ZackHirshhorn/Nested-Motor-Experiment/analysis/example/carrier_selection.md

# Carrier selection

Carrier at 3 V, inner at 3 V, cradle parasitic torque 0.8 mN·m.

| Carrier | Inner | carrier stall / τ_par | cradle rpm | ω_out free (rpm) | ideal sum of free speeds (rpm) | combined stall torque (mN·m) | verdict |
|---|---|---|---|---|---|---|---|
| A | B | 6.7 | 7467 | 17495 | 18798 | 3.82 | OK |
| B | A | 4.2 | 7668 | 16438 | 18798 | 3.59 | OK |

**Recommended carrier: motor A.**

Predicted role-swap effect on free-running ω_out: 1057 rpm (A as carrier is faster). Under output load both motors carry the same torque, so this difference stays constant along the combined torque-speed line.
