ZackHirshhorn/Nested-Motor-Experiment/analysis/example/motor_summary.md

# Phase 1 — motor characterization

Values at each motor's highest no-load test voltage. *Apparent kV* is the plan's definition (free rpm / V, includes friction and IR drop); *back-EMF kV* is 1/kE, the true motor constant. kT is fitted independently from the rope-brake points: it should match kE (same number in SI) if the data are self-consistent.

| Motor | V test | free rpm | apparent kV (rpm/V) | back-EMF kV (rpm/V) | kE = kT (mN·m/A) | kT from brake (mN·m/A) | R (Ω) | I0 @ free (A) | I stall (A) | τ stall (mN·m) | brake fit RMS (rpm) | J spin-up (g·cm²) | τ stall spin-up (mN·m) |
|---|---|---|---|---|---|---|---|---|---|---|---|---|---|
| A | 4.50 | 13346 | 2966 | 3185 | 2.998 | 2.934 | 1.600 | 0.194 | 2.81 | 8.19 | 141 | 4.91 | 5.47 |
| B | 4.50 | 15275 | 3394 | 3674 | 2.599 | 2.598 | 2.192 | 0.156 | 2.05 | 5.18 | 223 | 4.71 | 3.44 |
