ZackHirshhorn/Nested-Motor-Experiment/analysis/example/plots/carrier_selection.png

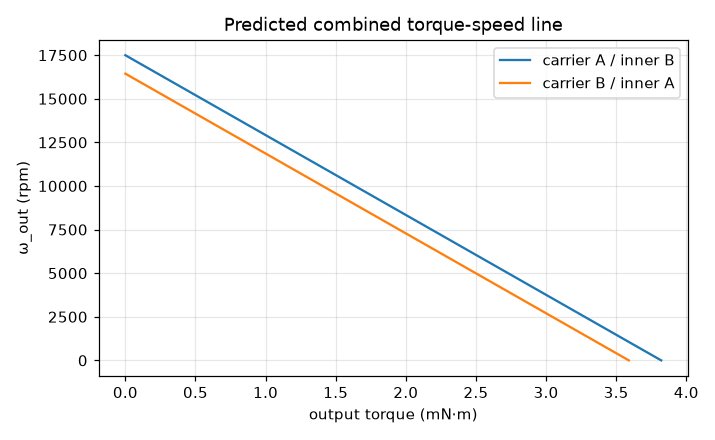
analysis/example/plots/carrier_selection.png
