ZackHirshhorn/Nested-Motor-Experiment/analysis/example/plots/torque_speed_A.png

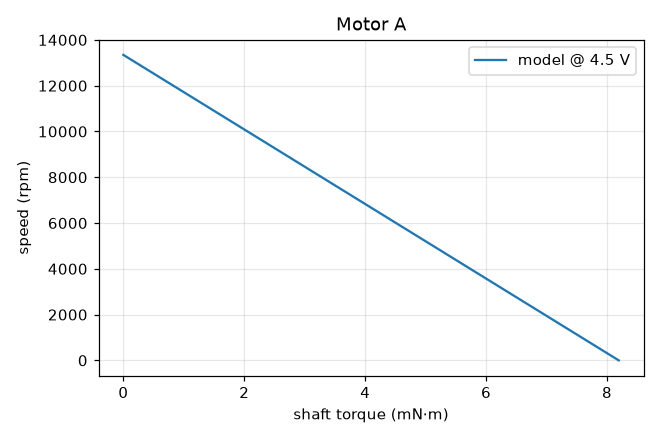
analysis/example/plots/torque_speed_A.png
