ZackHirshhorn/Nested-Motor-Experiment/analysis/example/plots/torque_speed_B.png

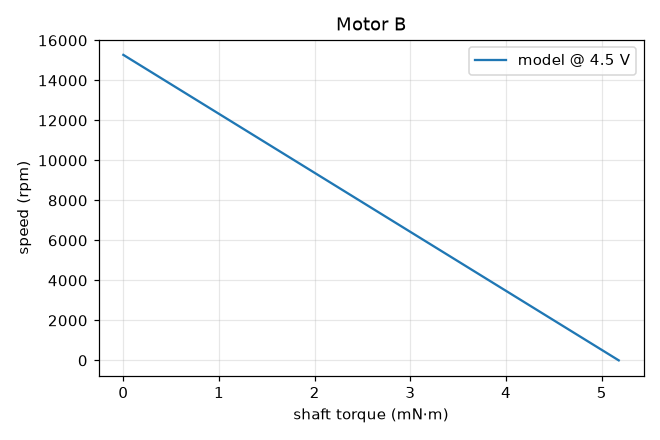
analysis/example/plots/torque_speed_B.png
