ZackHirshhorn/Nested-Motor-Experiment/docs/BOM.md

# Bill of Materials

_Generated by `python cad/rig.py` from the parametric model. Do not edit by hand; change cad/parameters.py or data/motor_dims.csv and re-run._

## Purchased parts

| Item | Qty | Spec / notes |
| --- | --- | --- |
| Brushed PM DC motor A | 1 | Exact model recorded in data/motor_dims.csv; characterized in Phase 1 |
| Brushed PM DC motor B | 1 | Same |
| Ball bearing 6801ZZ | 1 | 12x21x5 mm, metal shields (ZZ), NOT rubber-sealed 2RS (seal drag) |
| Ball bearing 6805ZZ | 1 | 25x37x7 mm, metal shields (ZZ), NOT rubber-sealed 2RS (seal drag) |
| Through-bore slip ring | 1 | >= 2 circuits, bore 12.7 mm, OD <= 40.0 mm, length <= 25.0 mm. **Choose the lowest rotating-torque spec you can find**: it must be well under the carrier's stall torque |
| Slotted opto-interrupter module (LM393 type) | 3 | 5 mm slot; 2 on the rig + 1 for the Phase 1 dynamometer |
| Arduino Uno / Nano (5 V) | 1 | Runs firmware/tachometer; timestamps pulses on D2 and D3 |
| Bench power supply, current-limited | 2 | One per motor, independently adjustable; current readout used as data |
| Multimeter | 1 | 4-wire resistance not needed; used for locked-rotor V/I and supply cross-checks |
| Digital force gauge (0-5 N, 0.01 N) + hanging masses (10-200 g) | 1 set | Rope-brake dynamometer |
| Braided cord, ~0.5 mm (fishing line / kevlar thread) | 1 m | Rope brake |
| Steel fender washer (e.g. M8 x 24 mm) | 1 | Known-inertia flywheel for the spin-up test; weigh it |
| Calipers | 1 | Motor dimensions and fit-coupon checks |
| Drill bit = motor shaft diameter (e.g. 2.0 mm) | 1 | Ream every printed shaft bore to size |
| Thin silicone hook-up wire (28-30 AWG) | 1 m | Inner motor leads through the rear cap to the slip ring |
| M3 x 10 screw + nut | 1 | Anti-rotation pin on the slip-ring stator (rides in the stop's window) |
| Clear polycarbonate sheet or printed guard | 1 | Shield around the spinning cradle (see Safety) |
| CA glue | - | Optional: lock press-fit discs on shafts |
| M3 heat-set insert | 25 | |
| M3 x 10 SHCS (base plate, from below) | 14 | |
| M3 x 12 SHCS (carrier mount cap) | 4 | |
| M3 x 16 SHCS (pedestal caps) | 2 | |
| M3 x 25 SHCS (pedestal caps) | 2 | |
| M3 x 6 set screw + M3 square nut (coupler hub) | 1 | |
| M3 x 8 SHCS (rear cap to cradle) | 3 | |

## 3D-printed parts

STLs are print-oriented in `cad/exports/carrier_<X>/`. Print `fit_coupon.stl` first and tune the fits in cad/parameters.py before printing the rest.

| Part | Qty | Material / notes |
| --- | --- | --- |
| base_plate.stl | 1 | PETG |
| carrier_mount_cap_A.stl | 1 | PETG |
| carrier_mount_cap_B.stl | 1 | PETG |
| carrier_mount_lower_A.stl | 1 | PETG |
| carrier_mount_lower_B.stl | 1 | PETG |
| coupler_hub.stl | 1 | PETG |
| cradle_body_A.stl | 1 | PETG, 100% infill (balance) |
| cradle_body_B.stl | 1 | PETG, 100% infill (balance) |
| dyno_drum_A.stl | 1 | PETG, supports under disc |
| dyno_drum_B.stl | 1 | PETG, supports under disc |
| encoder_disc_A.stl | 1 | PLA or PETG |
| encoder_disc_B.stl | 1 | PLA or PETG |
| oldham_disc.stl | 1 | PETG, supports under web |
| pedestal_front_cap.stl | 1 | PETG |
| pedestal_front_lower.stl | 1 | PETG |
| pedestal_rear_cap.stl | 1 | PETG |
| pedestal_rear_lower.stl | 1 | PETG |
| rear_cap_A.stl | 1 | PETG, 100% infill (balance) |
| rear_cap_B.stl | 1 | PETG, 100% infill (balance) |
| sensor_bracket.stl | 3 | PLA or PETG |
| slip_ring_stop.stl | 1 | PLA or PETG |
