ZackHirshhorn/Nested-Motor-Experiment/cad/exports/carrier_A/assembly_phase3_loaded.step

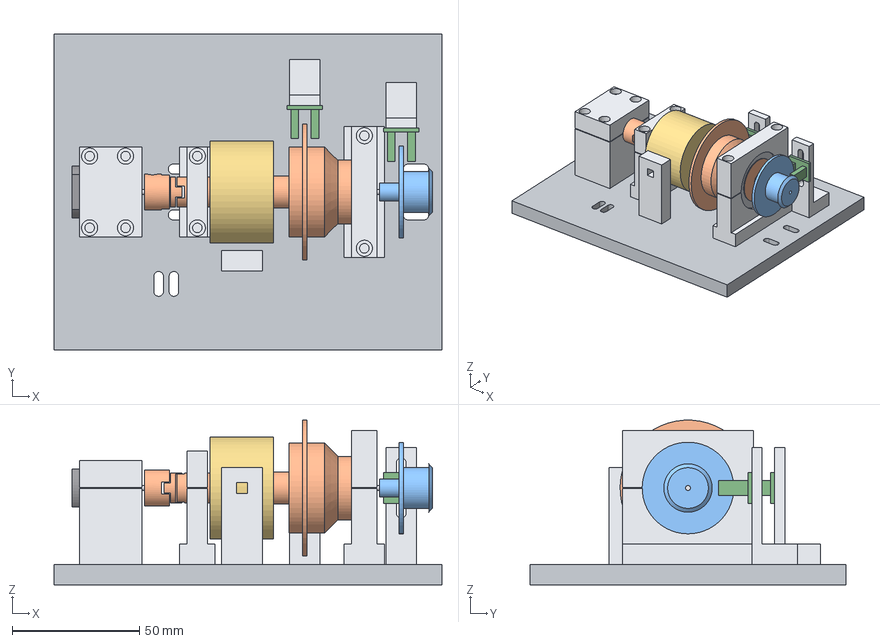
[picture p5: CAD file, 2026-10-30]
cad/exports/carrier_A/assembly_phase3_loaded.step
152.4 x 124.0 x 64.6 mm
base_plate
carrier_mount_lower
carrier_mount_cap
motor_carrier_can
motor_carrier_shaft
pedestal_front_lower
pedestal_front_cap
pedestal_rear_lower
pedestal_rear_cap
cradle_body
rear_cap
oldham_disc
coupler_hub
motor_inner_can
motor_inner_shaft
slip_ring_stop
slip_ring
bearing_front
bearing_rear
sensor_bracket
sensor_cradle
sensor_bracket_output
sensor_output
dyno_drum_inner
