ZackHirshhorn/Nested-Motor-Experiment/cad/exports/carrier_B/assembly_phase1.step

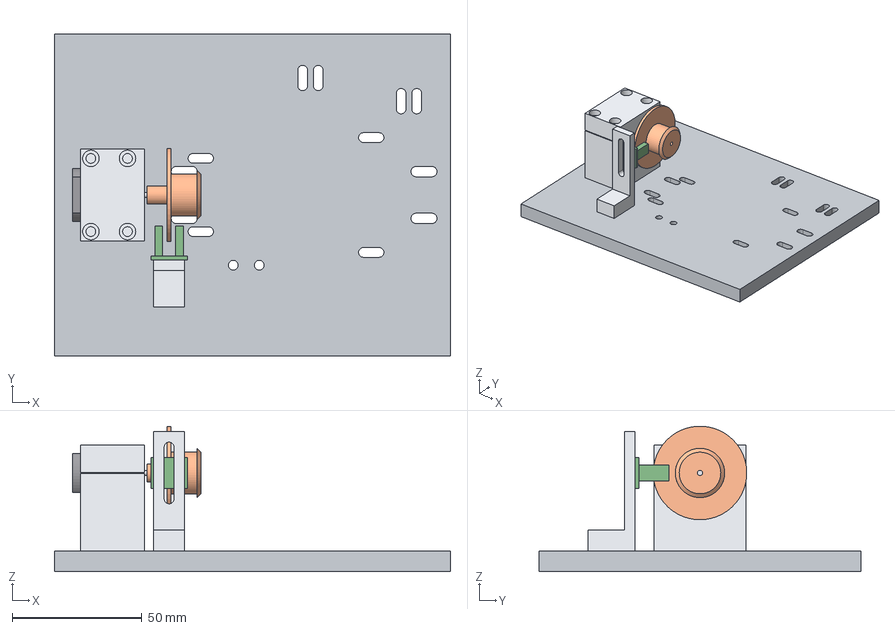
[picture p6: CAD file, 2026-10-30]
cad/exports/carrier_B/assembly_phase1.step
152.4 x 124.0 x 56.0 mm
base_plate
carrier_mount_lower
carrier_mount_cap
motor_carrier_can
motor_carrier_shaft
dyno_drum_carrier
sensor_bracket_p1
sensor_p1
