ZackHirshhorn/Nested-Motor-Experiment/cad/exports/carrier_A/encoder_disc_B.stl

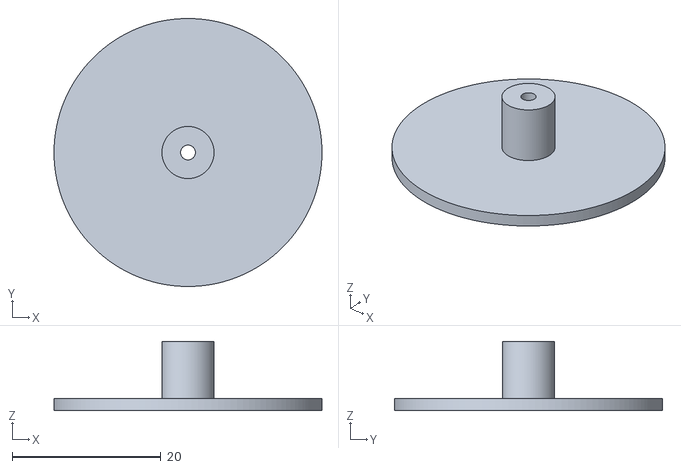
[picture p7: CAD file, 2026-10-30]
cad/exports/carrier_A/encoder_disc_B.stl
36.0 x 36.0 x 9.30
