ZackHirshhorn/Nested-Motor-Experiment/cad/exports/carrier_B/pedestal_rear_lower.stl

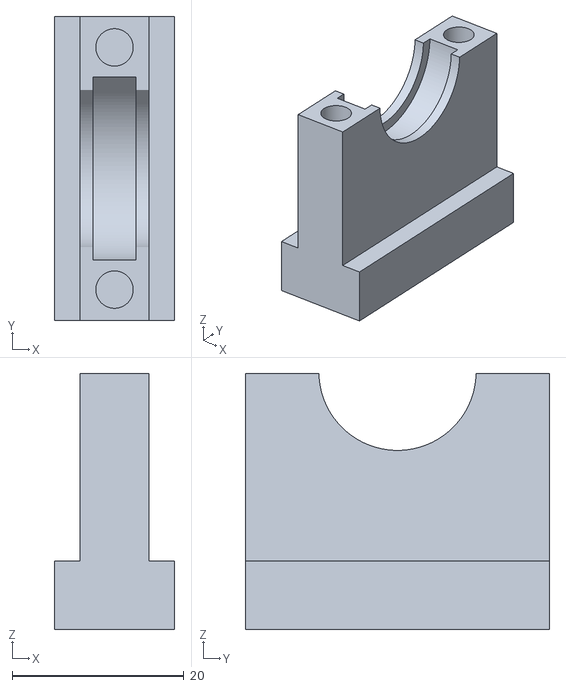
[picture p8: CAD file, 2026-10-30]
cad/exports/carrier_B/pedestal_rear_lower.stl
14.0 x 35.4 x 29.8
