ZackHirshhorn/Nested-Motor-Experiment/cad/exports/carrier_A/sensor_bracket.stl

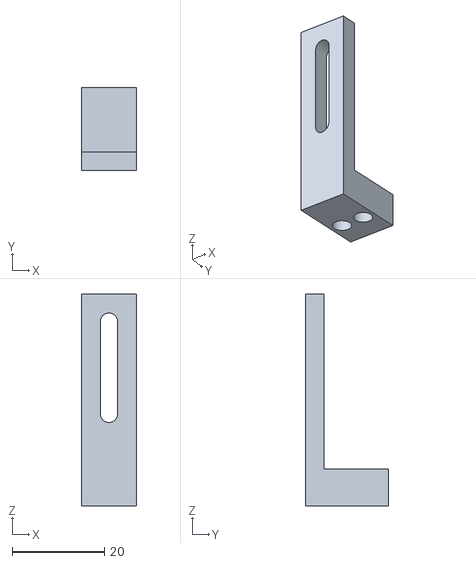
[picture p9: CAD file, 2026-10-30]
cad/exports/carrier_A/sensor_bracket.stl
12.0 x 18.0 x 46.0
