ZackHirshhorn/Nested-Motor-Experiment/cad/exports/carrier_B/pedestal_rear_cap.stl

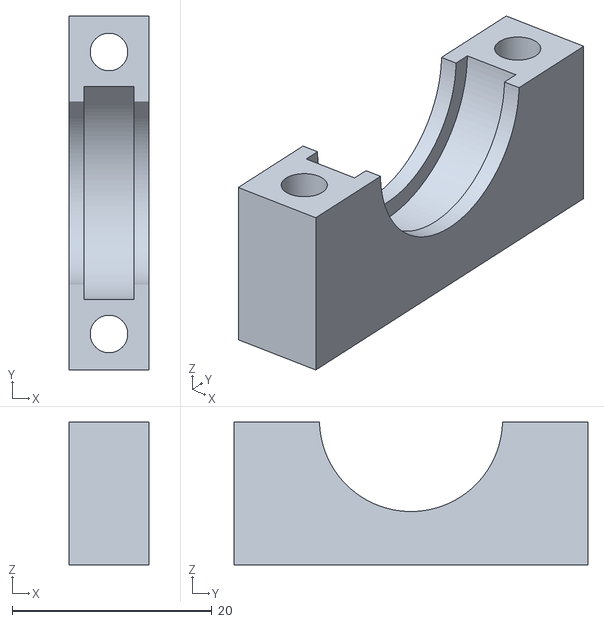
[picture p10: CAD file, 2026-10-30]
cad/exports/carrier_B/pedestal_rear_cap.stl
8.00 x 35.4 x 14.3
