ZackHirshhorn/Nested-Motor-Experiment/cad/exports/carrier_A/slip_ring_stop.stl

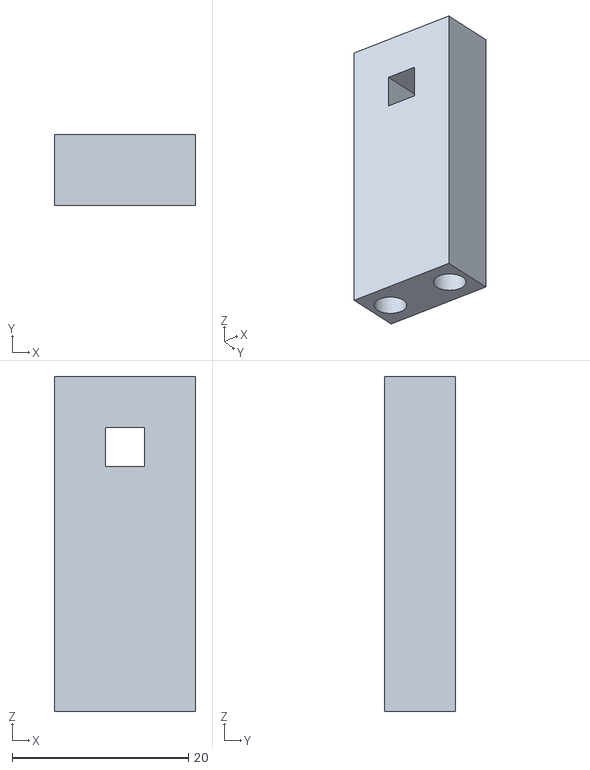
[picture p11: CAD file, 2026-10-30]
cad/exports/carrier_A/slip_ring_stop.stl
16.0 x 8.00 x 38.0
