ZackHirshhorn/Nested-Motor-Experiment/cad/exports/carrier_B/fit_coupon.stl

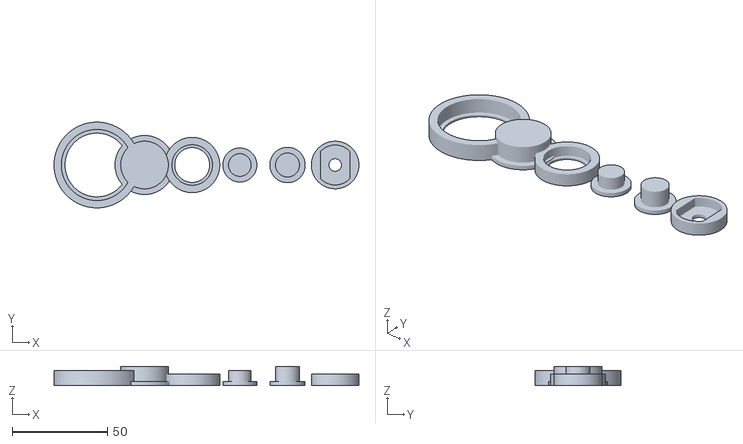
[picture p12: CAD file, 2026-10-30]
cad/exports/carrier_B/fit_coupon.stl
160.0 x 45.0 x 10.0
