ZackHirshhorn/Nested-Motor-Experiment/cad/exports/carrier_A/carrier_mount_lower_A.stl

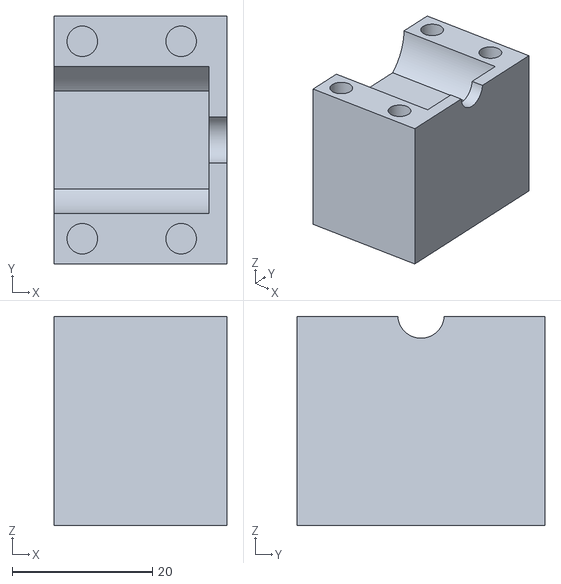
[picture p13: CAD file, 2026-10-30]
cad/exports/carrier_A/carrier_mount_lower_A.stl
24.6 x 35.3 x 29.8
