ZackHirshhorn/Nested-Motor-Experiment/cad/exports/carrier_B/carrier_mount_cap_B.stl

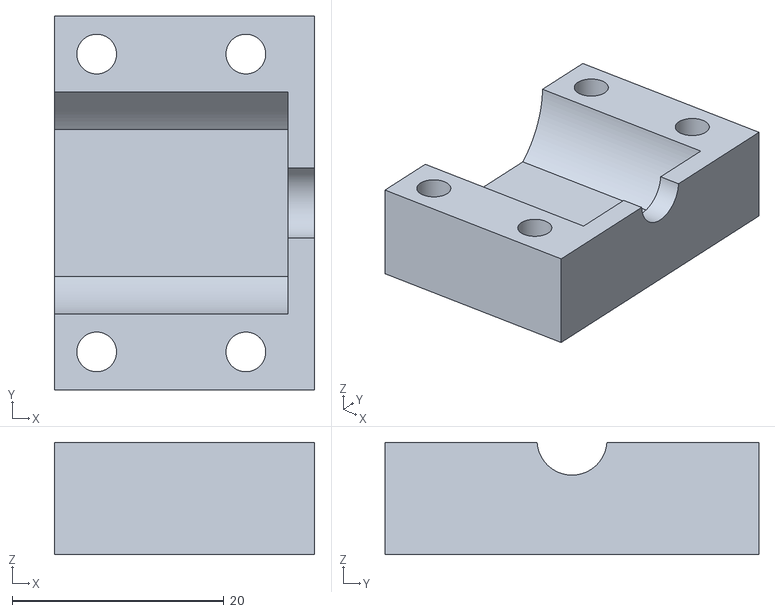
[picture p14: CAD file, 2026-10-30]
cad/exports/carrier_B/carrier_mount_cap_B.stl
24.6 x 35.3 x 10.6
