ZackHirshhorn/Nested-Motor-Experiment/cad/exports/carrier_B/dyno_drum_A.stl

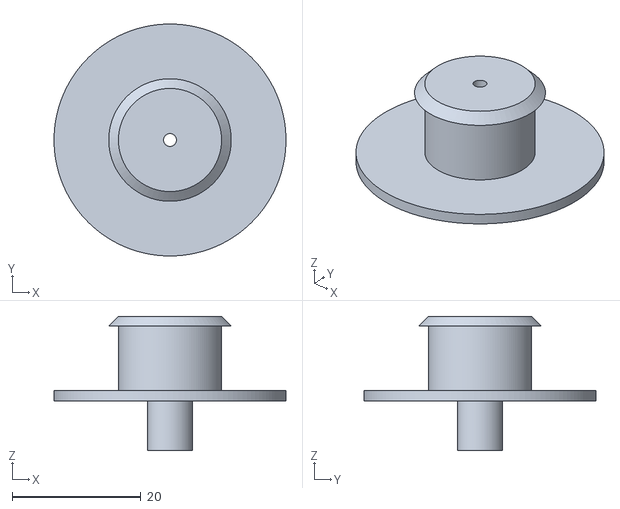
[picture p15: CAD file, 2026-10-30]
cad/exports/carrier_B/dyno_drum_A.stl
36.0 x 36.0 x 20.8
