ZackHirshhorn/Nested-Motor-Experiment/cad/exports/carrier_B/coupler_hub.stl

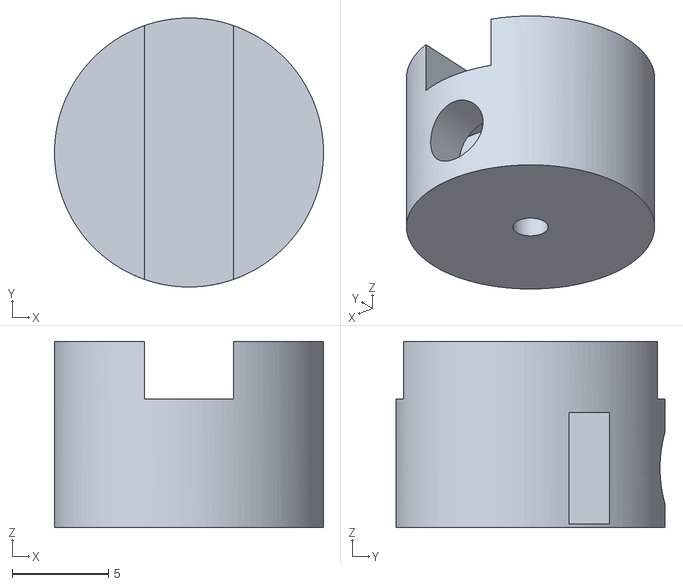
[picture p16: CAD file, 2026-10-30]
cad/exports/carrier_B/coupler_hub.stl
14.0 x 14.0 x 9.70
