ZackHirshhorn/Nested-Motor-Experiment/cad/exports/carrier_A/cradle_body_B.stl

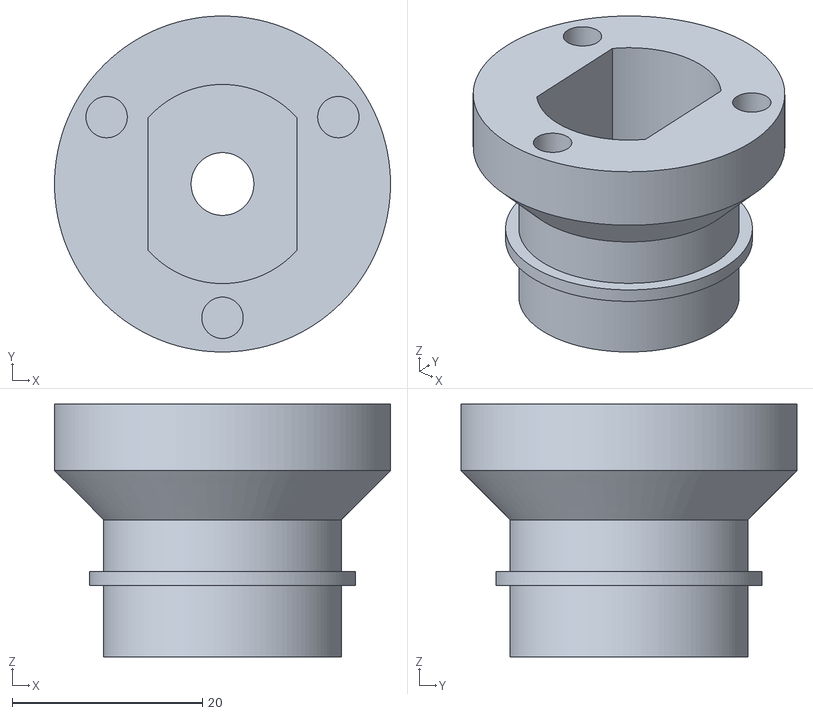
[picture p17: CAD file, 2026-10-30]
cad/exports/carrier_A/cradle_body_B.stl
35.3 x 35.3 x 26.6
