ZackHirshhorn/Nested-Motor-Experiment/cad/exports/carrier_A/rear_cap_B.stl

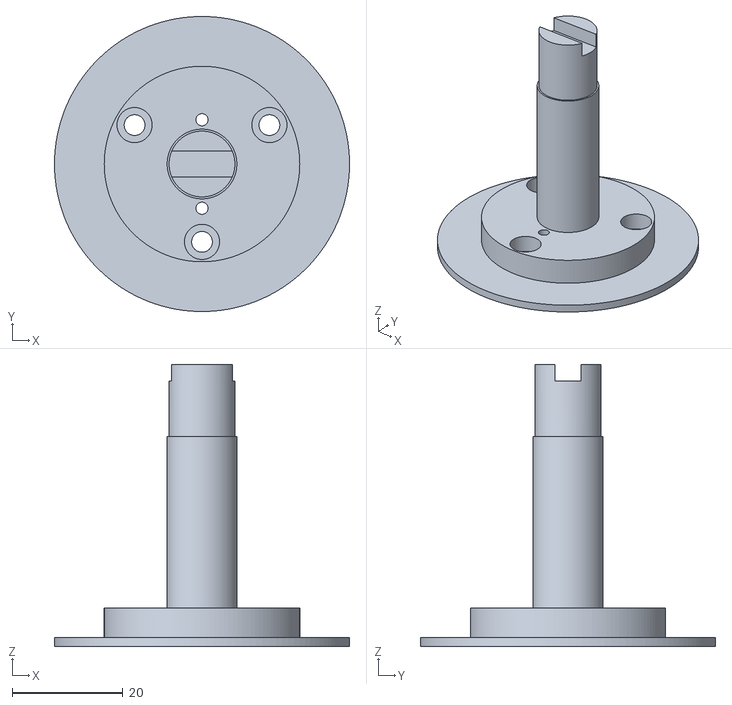
[picture p18: CAD file, 2026-10-30]
cad/exports/carrier_A/rear_cap_B.stl
53.3 x 53.3 x 51.0
