ZackHirshhorn/Nested-Motor-Experiment/cad/exports/carrier_B/oldham_disc.stl

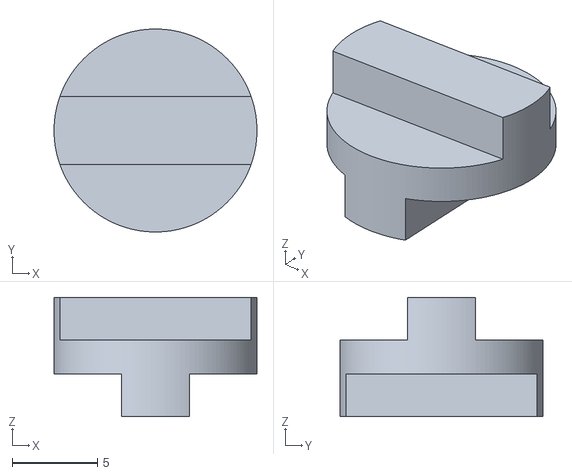
[picture p19: CAD file, 2026-10-30]
cad/exports/carrier_B/oldham_disc.stl
11.9 x 11.9 x 7.00
