ZackHirshhorn/Nested-Motor-Experiment/cad/exports/carrier_A/base_plate.stl

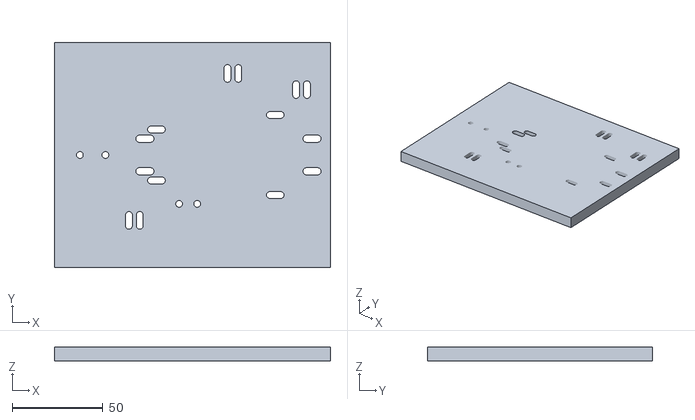
[picture p20: CAD file, 2026-10-30]
cad/exports/carrier_A/base_plate.stl
152.4 x 124.1 x 8.00
