ZackHirshhorn/Nested-Motor-Experiment/cad/exports/carrier_A/pedestal_front_lower.stl

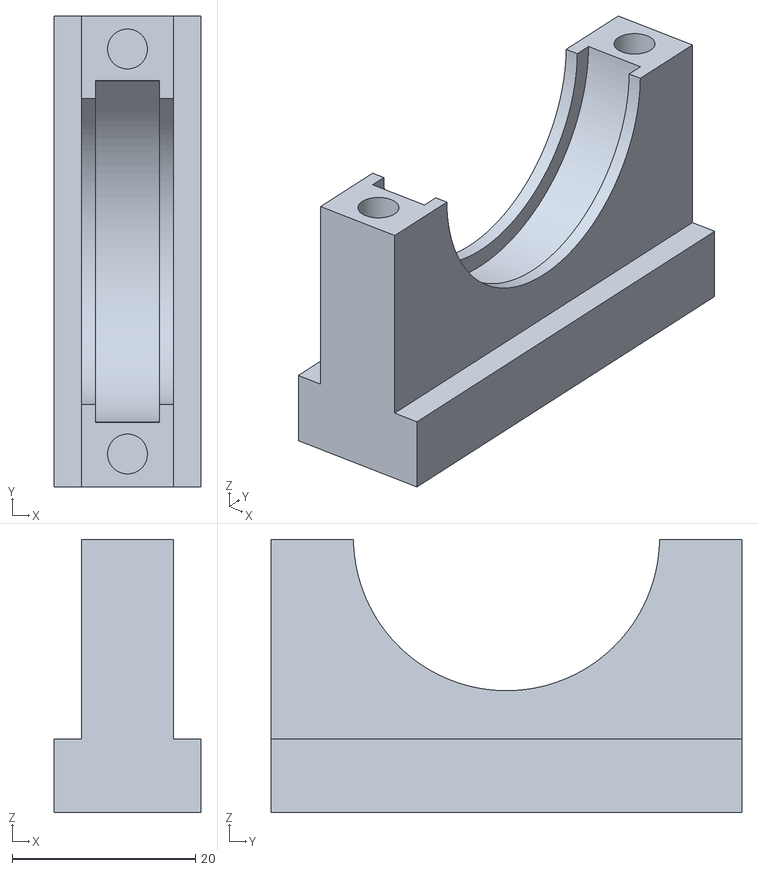
[picture p21: CAD file, 2026-10-30]
cad/exports/carrier_A/pedestal_front_lower.stl
16.0 x 51.4 x 29.8
