ZackHirshhorn/Nested-Motor-Experiment/cad/exports/carrier_A/pedestal_front_cap.stl

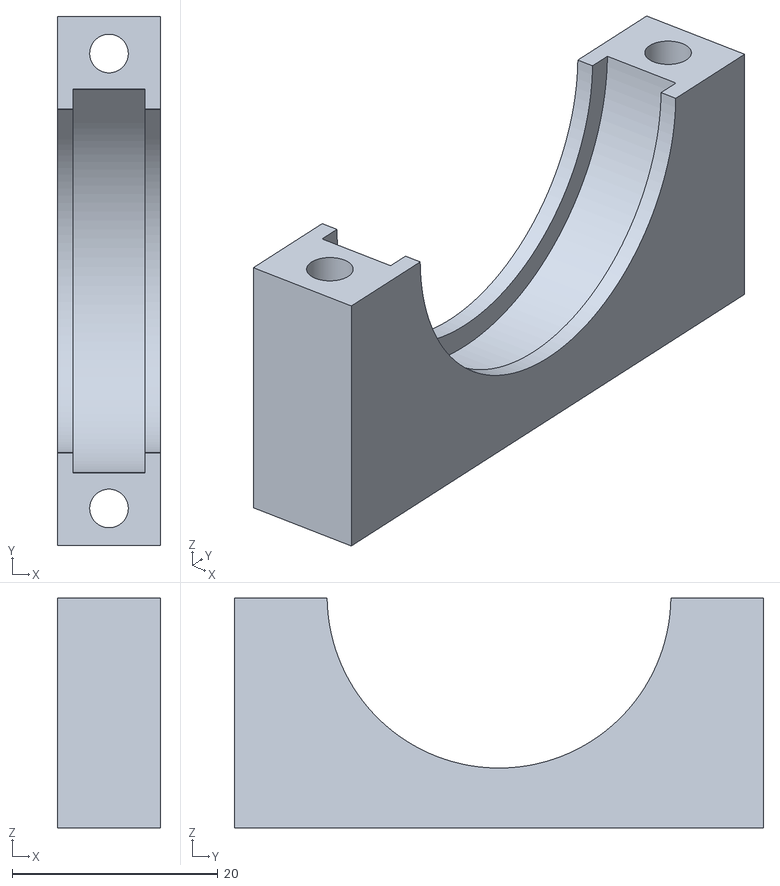
[picture p22: CAD file, 2026-10-30]
cad/exports/carrier_A/pedestal_front_cap.stl
10.0 x 51.4 x 22.3
