ZackHirshhorn/Nested-Motor-Experiment/(list of files, cad)

Other CAD files:
cad/exports/carrier_B/assembly_phase3_loaded.step
cad/exports/rig_assembly.step
cad/exports/carrier_A/assembly_phase3.step
cad/exports/carrier_A/assembly_phase1.step
cad/exports/carrier_B/assembly_phase3.step
