ZackHirshhorn/Nested-Motor-Experiment/(commit log)

2026-10-30 Design nested DC-motor rotation experiment
    Implements the four-phase plan in docs/: parametric build123d CAD for
    every printed part (with automatic running-clearance checks and a
    generated BOM), motor characterization and carrier-selection analysis,
    a series-coupling prediction model compared against measured runs, a
    two-channel Arduino tachometer with serial logger, and design notes,
    procedure and assembly docs.
    Motor, slip-ring and sensor dimensions are still ASSUMED placeholders;
    see docs/DESIGN_NOTES.md section 7 before printing.
    [combined_runs.csv, motor_A.csv, motor_A.json, motor_B.csv, motor_B.json, motor_dims.csv, spinup_A_base.csv, spinup_A_flywheel.csv]
2026-10-30 Commit generated CAD exports
    Track the print-oriented STLs and assembly STEPs for both role
    configurations so the printable files are available without running
    cad/rig.py. They must be regenerated and committed alongside any CAD
    or parameter change (noted in CLAUDE.md).
    [assembly_phase1.step, assembly_phase3.step, assembly_phase3_loaded.step, base_plate.stl, carrier_mount_cap_A.stl, carrier_mount_cap_B.stl, carrier_mount_lower_A.stl, carrier_mount_lower_B.stl]
2026-10-30 Add colored full-rig assembly STEP
    cad/exports/rig_assembly.step holds the complete running rig (24 named
    parts) for viewing in any CAD tool. All assembly STEPs are now colored
    by role: orange spins with the cradle, blue at output speed, grey
    static, with distinct colors for motors, bearings, slip ring and
    sensors.
    [assembly_phase1.step, assembly_phase3.step, assembly_phase3_loaded.step, rig_assembly.step]
